DanaAlkattan/ECE411-Project/Final BOM List.xlsx

Qty | Value | Device | Package | Parts | Description | Unit Price | Extended Price | Price per Board | Datasheet
3 |  | BATTERY-AAA_KIT | BATTERY-AAA-KIT | BT1, BT2, BT3 | Battery - Single Cell | $0.40 | 10.80/27 | $2.40 | http://www.mouser.com/ds/2/215/2-743115.pdf
10 |  | PINHD-1X1 | 1X01 | 0G, 3.3V, 5V, GND, GS, SL, ST, X, Y, Z | Pin header 1x1 for 0.1" spacing | $10.99 |  | $10.99 | https://dl.dropboxusercontent.com/content_link/imm0ZKoNwz7TbJB7V2Qy4pkyaAe6W9NZotIhQMa9fvJXiW9WUb1BNVgtXOhdd12s/file
1 |  | SEGMENT_8X8_ROWCATHODEM12A881UR | SEGMENT_BL-M12A881UR | LED-MATRIX | 8x8 LED Segment Displays: Row = Cathode | $6.93 |  | $6.93 | https://www.sparkfun.com/datasheets/Components/SanYoung-Medium-RG.pdf
1 |  | SWITCH-SPSTPTH_LOCK | SWITCH-SPDT_LOCK.007S | SW | SPST Switch | $0.11 | 5.31/ 50 | $0.11 | https://cdn.sparkfun.com/datasheets/Components/Switches/1193302209860_SS12D01-A.gif
5 | 0.1 uF | C-USC0805 | C0805 | C1, C3, C4, C8, C10 | CAPACITOR, American symbol | $0.09 | 2.67/30 | $0.44 | http://www.mouser.com/ds/2/212/KEM_C1023_X7R_AUTO_SMD-1093309.pdf
2 | 10 K | 10KOHM-0603-1/10W-1% | 603 | R10, R11 | 10kO resistor | $0.03 | 6.52/200 | $0.07 | http://www.mouser.com/ds/2/414/WIN-534129-1210153.pdf
1 | 10uH | L | L1812 | L2 | INDUCTOR, European symbol | $1.00 | 9.96/10 | $1.00 | http://www.mouser.com/ds/2/400/b82432a-1092831.pdf
8 | 150 | 150OHM-0603-1/10W-1% | 603 | R1, R2, R3, R4, R5, R6, R7, R8 | 150O resistor | $0.01 | 7.00/500 | $0.12 | http://www.mouser.com/ds/2/427/crcw0201e3-239671.pdf
1 | 2.2uF | C-USC0805 | C0805 | C2 | CAPACITOR, American symbol | $0.15 | 1.49/10 | $0.15 | http://www.mouser.com/ds/2/396/mlcc11_hq_e-541564.pdf
1 | 3.3V/150mA | V_REG_MIC52053.3V | SOT23-5 | U3 | V_REG MIC5205 Standard 3.3V, 5V | $0.48 | 2.40/5 | $0.48 | http://www.mouser.com/ds/2/268/mic5205-778789.pdf
1 | 328P | ATMEGA328P_PDIP | DIP28 | U1 | Atmel 328P | $4.00 |  | $4.00 | http://www.atmel.com/Images/Atmel-42735-8-bit-AVR-Microcontroller-ATmega328-328P_Datasheet.pdf
1 | 470pF | C-USC0805 | C0805 | C9 | CAPACITOR, American symbol | $0.64 | 6.40/10 | $0.64 | http://www.mouser.com/ds/2/40/AVX-MM-1021715.pdf
1 | AVRISP-6 | AVRISP-6 | AVRISP | ISP | AVR ISP HEADER | $0.45 | 2.25/5 | $0.45 | N/A
1 | MOMENTARY-SWITCH-SPST-PTH-6.0MM | MOMENTARY-SWITCH-SPST-PTH-6.0MM | TACTILE_SWITCH_PTH_6.0MM | S1 | Momentary Switch (Pushbutton) - SPST | $0.06 | 5.99/100 | $0.06 | https://www.onlinecomponents.com/datasheet/mjtp1230.aspx?p=10578901
2 | SN74HC595N | 74HC595N | DIP16 | U5, U6 | 8-Bit Shift Register (Serial to Parallel) | $1.50 | 6.01/4 | $3.00 | https://www.sparkfun.com/datasheets/IC/SN74HC595.pdf
 |  |  |  |  | Cost per one Board = |  |  | $30.83
 |  |  |  |  | Board Manufacturing = |  |  | $16
 |  |  |  |  | Total Cost = |  |  | $46.83
