DanaAlkattan/ECE411-Project/(threads)

Thread 2 (2017-11-08):

Premilinary Board layout

AndrewV0, 2017-11-08:
Having some vias that needed to be fixed. I'm not really an expert with EagleCad yet.

Closed 2017-11-21.
