DanaAlkattan/ECE411-Project/Schematic_withShiftResister.brd

## EAGLE design Schematic_withShiftResister.brd (2017-11-16)

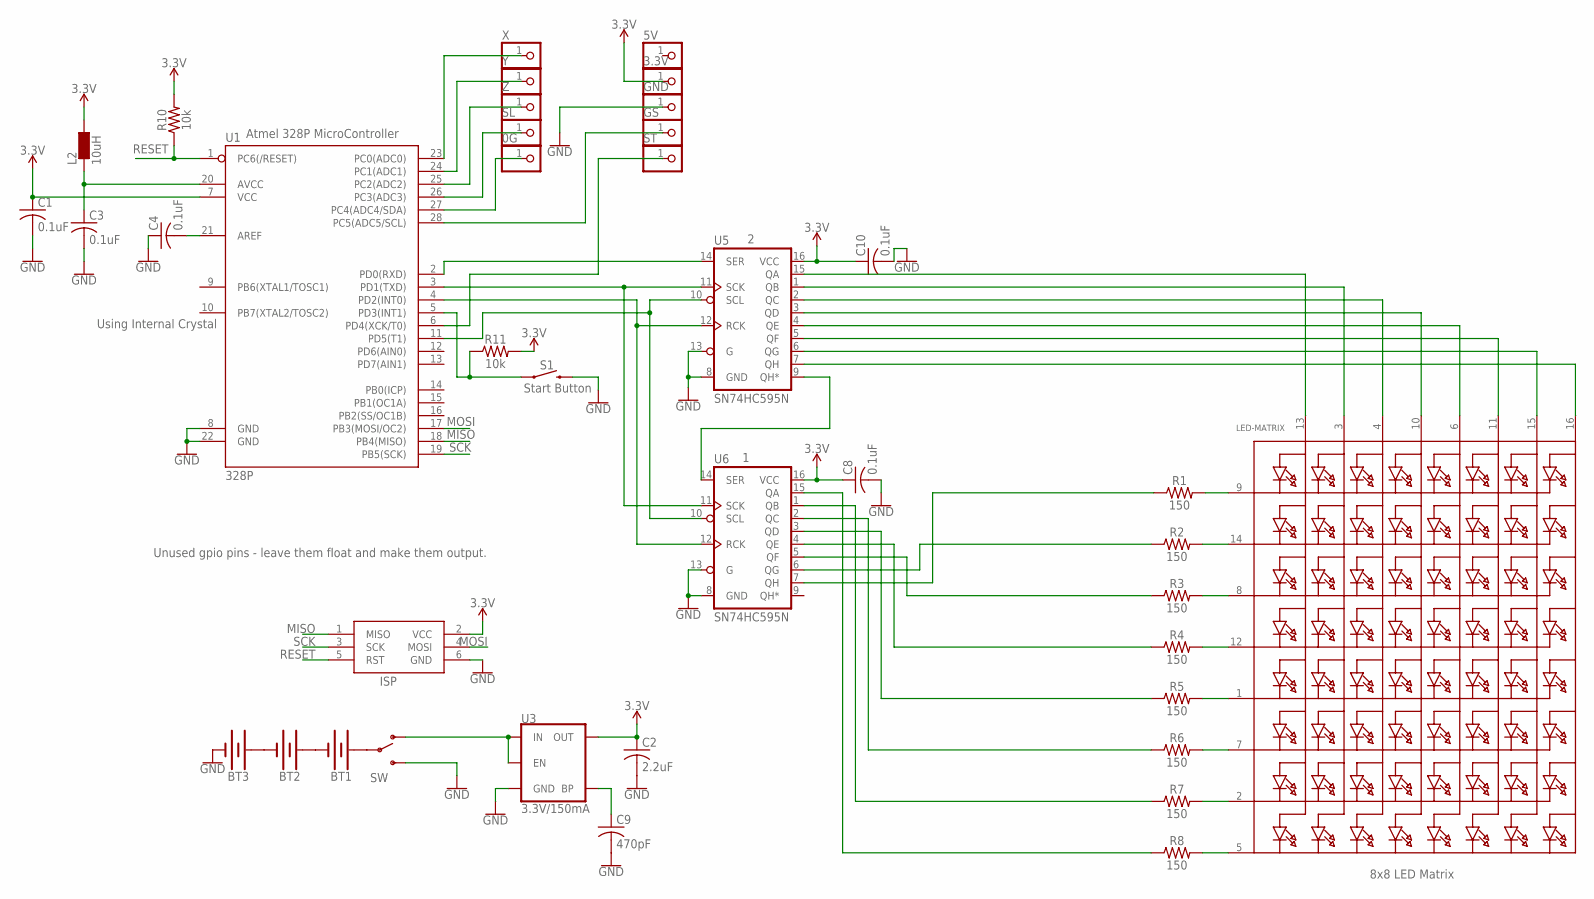
[picture p17: schematic Schematic_withShiftResister.sch]

Parts:
0G, 3.3V, 5V: PINHD-1X1; 1X01
BT1, BT2, BT3: BATTERY-AAA_KIT; BATTERY-AAA-KIT
C1, C3, C4, C8, C10: 0.1uF; C0805
C2: 2.2uF; C0805
C9: 470pF; C0805
GND: PINHD-1X1; 1X01
GS: PINHD-1X1; 1X01
ISP: AVRISP-6; AVRISP
L2: 10uH; L1812
LED-MATRIX: SEGMENT_8X8_ROWCATHODEM12A881UR; SEGMENT_BL-M12A881UR
R1, R2, R3, R4, R5, R6, R7, R8: 150; 0603
R10, R11: 10k; 0603
S1: MOMENTARY-SWITCH-SPST-PTH-6.0MM; TACTILE_SWITCH_PTH_6.0MM
SL: PINHD-1X1; 1X01
ST: PINHD-1X1; 1X01
SW: SWITCH-SPSTPTH_LOCK; SWITCH-SPDT_LOCK.007S
U1: 328P; DIP28
U3: 3.3V/150mA; SOT23-5
U5, U6: SN74HC595N; DIP16
X: PINHD-1X1; 1X01
Y: PINHD-1X1; 1X01
Z: PINHD-1X1; 1X01

Connections:
3.3V: 3.3V.1, C1.1, C2.1, C8.1, C10.1, ISP.2 (VCC), L2.1, R10.2, R11.2, U1.7 (VCC), U3.5 (OUT), U5.16 (VCC), U6.16 (VCC)
GND: BT3.GND@1 (-), C1.2, C2.2, C3.2, C4.1, C8.2, C9.2, C10.2, GND.1, ISP.6 (GND), S1.3 (2), SW.3 (S), U1.8 (GND), U1.22 (GND), U3.2 (GND), U5.8 (GND), U5.13 (G), U6.8 (GND), U6.13 (G)
MISO: ISP.1 (MISO), U1.18 (PB4(MISO))
MOSI: ISP.4 (MOSI), U1.17 (PB3(MOSI/OC2))
unnamed: LED-MATRIX.9 (K1), R1.2
unnamed: LED-MATRIX.14 (K2), R2.2
unnamed: LED-MATRIX.8 (K3), R3.2
unnamed: LED-MATRIX.1 (K5), R5.2
unnamed: LED-MATRIX.7 (K6), R6.2
unnamed: LED-MATRIX.2 (K7), R7.2
unnamed: LED-MATRIX.5 (K8), R8.2
unnamed: LED-MATRIX.13 (A1), U5.15 (QA)
unnamed: LED-MATRIX.4 (A3), U5.2 (QC)
unnamed: LED-MATRIX.10 (A4), U5.3 (QD)
unnamed: LED-MATRIX.6 (A5), U5.4 (QE)
unnamed: LED-MATRIX.11 (A6), U5.5 (QF)
unnamed: LED-MATRIX.15 (A7), U5.6 (QG)
unnamed: LED-MATRIX.16 (A8), U5.7 (QH)
unnamed: R8.1, U6.15 (QA)
unnamed: U1.23 (PC0(ADC0)), X.1
unnamed: U1.24 (PC1(ADC1)), Y.1
unnamed: U1.25 (PC2(ADC2)), Z.1
unnamed: R7.1, U6.1 (QB)
unnamed: R6.1, U6.2 (QC)
unnamed: R5.1, U6.3 (QD)
unnamed: R4.1, U6.4 (QE)
unnamed: R3.1, U6.5 (QF)
unnamed: R2.1, U6.6 (QG)
unnamed: R1.1, U6.7 (QH)
unnamed: LED-MATRIX.3 (A2), U5.1 (QB)
unnamed: U1.3 (PD1(TXD)), U5.11 (SCK), U6.11 (SCK)
unnamed: SW.1 (O), U3.1 (IN), U3.3 (EN)
unnamed: BT2.GND@1 (-), BT3.PWR@1 (+)
unnamed: BT1.GND@1 (-), BT2.PWR@1 (+)
unnamed: C9.1, U3.4 (BP)
unnamed: U1.2 (PD0(RXD)), U5.14 (SER)
unnamed: U5.9 (QH*), U6.14 (SER)
unnamed: U1.4 (PD2(INT0)), U5.12 (RCK), U6.12 (RCK)
unnamed: BT1.PWR@1 (+), SW.2
unnamed: C4.2, U1.21 (AREF)
unnamed: U1.11 (PD5(T1)), U5.10 (SCL), U6.10 (SCL)
unnamed: R11.1, S1.1, U1.5 (PD3(INT1))
unnamed: SL.1, U1.26 (PC3(ADC3))
unnamed: 0G.1, U1.27 (PC4(ADC4/SDA))
unnamed: C3.1, L2.2, U1.20 (AVCC)
unnamed: GS.1, U1.28 (PC5(ADC5/SCL))
unnamed: ST.1, U1.6 (PD4(XCK/T0))
RESET: ISP.5 (RST), R10.1, U1.1 (PC6(/RESET))
SCK: ISP.3 (SCK), U1.19 (PB5(SCK))

Notes on the sheet:
Atmel 328P MicroController
8x8 LED Matrix
Start Button
Using Internal Crystal
Unused gpio pins - leave them float and make them output.

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
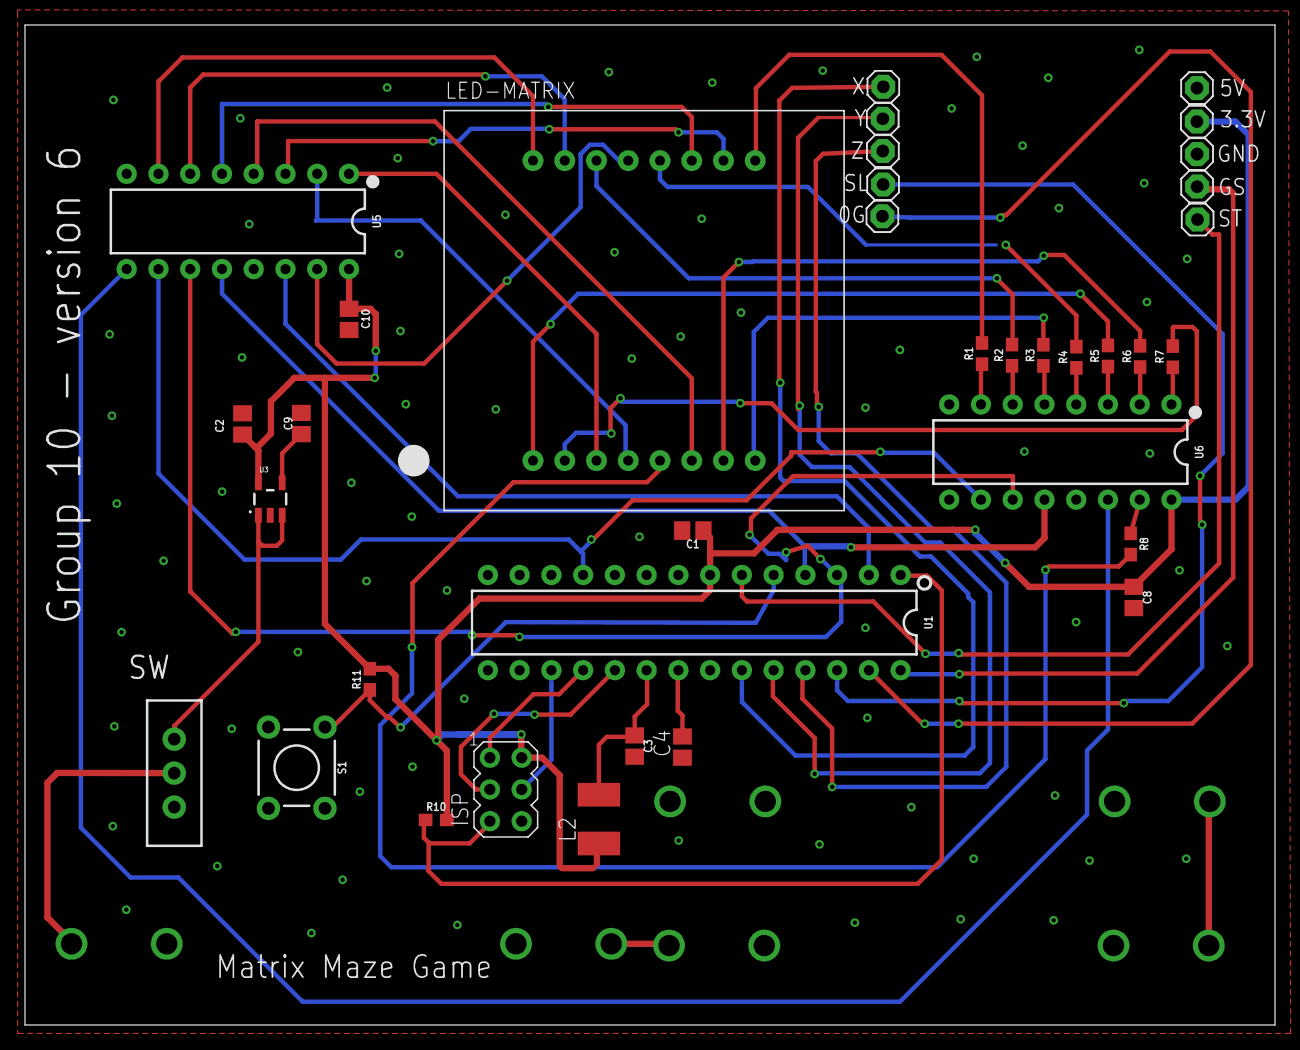
[picture p18: board Schematic_withShiftResister.brd from above]

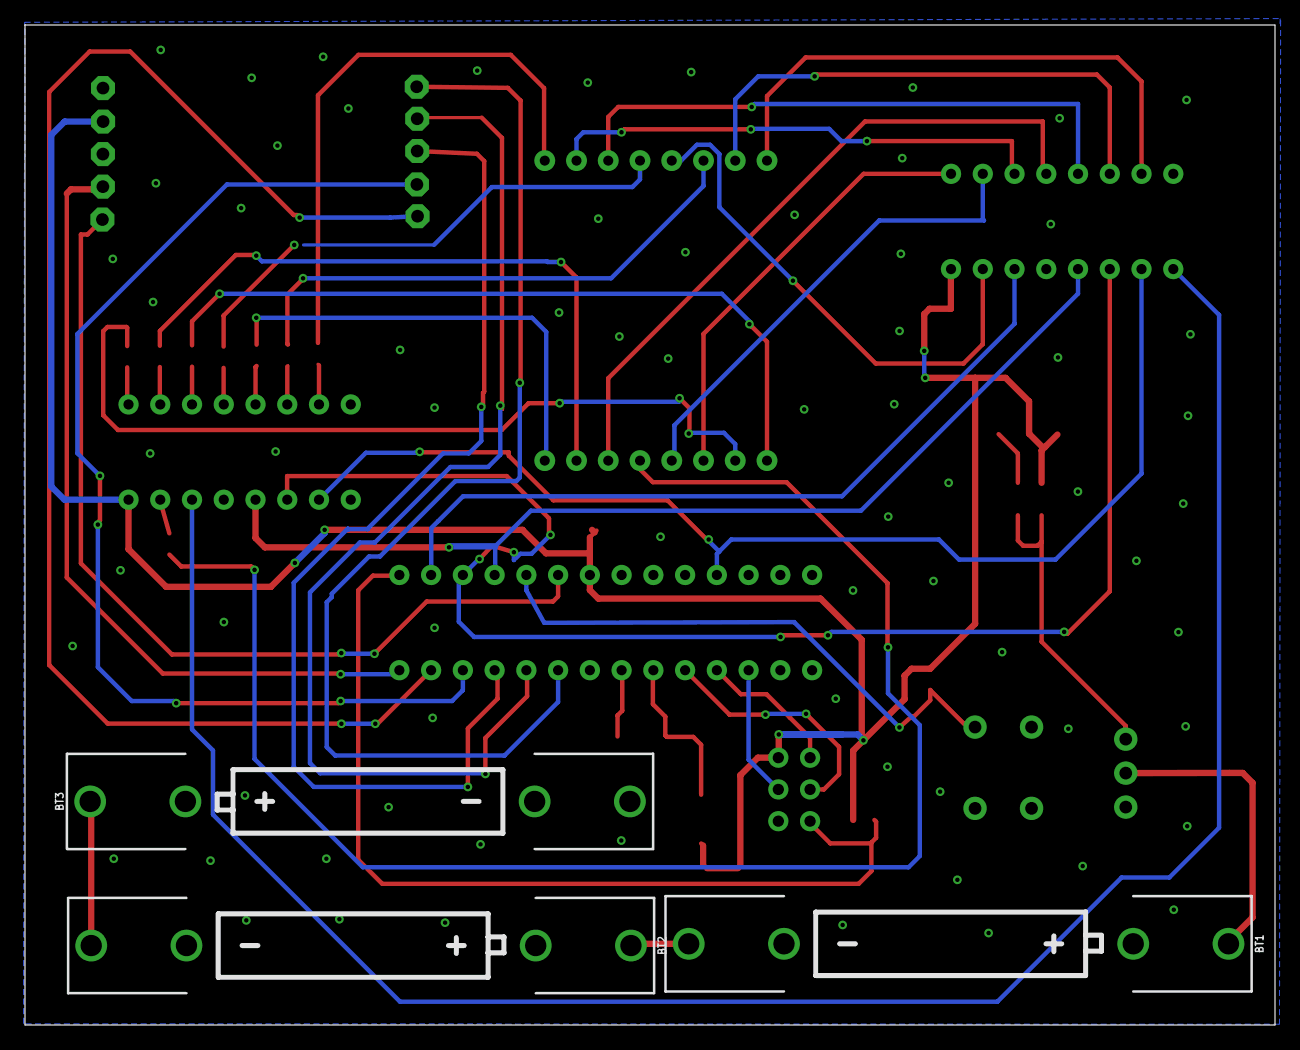
[picture p19: board Schematic_withShiftResister.brd from below]

Board: 2 copper layers, 100.0 x 80.0 mm, 39 parts (3 on the bottom side), 49 nets.
