DanaAlkattan/ECE411-Project/(commit log)

2017-11-02 corrected errors
    separated buttons and leds. connect resistors between LEDs and GND. connect unused Atmega pins to GND. connect DIN on MAX 7219 to MOSI on atmega328. removed resistors btw outputs on MAX 7219. added Rref to Iref pin on 7219. Added pullup resistor to Dout 7219. Added recommended capacitors to Vcc on 7219. Changed 7219 power supply to 4.5 V. connected Gselect on 7361 to PD5 on atmega. Connected VSS to GND on 3761. Connected #SLEEP and ST to pin PD6 and PD7 on atmega, respectively. Added bypass capacitor to Vcc for 7361. Added LC circuit to AVCC. Connect Aref to +3.3V.
    [finalschematic.sch]
2017-11-25 arduino code ported to C
